valentinbasel/icaro-pcb/svg/pinguicaro-B_Mask.pdf

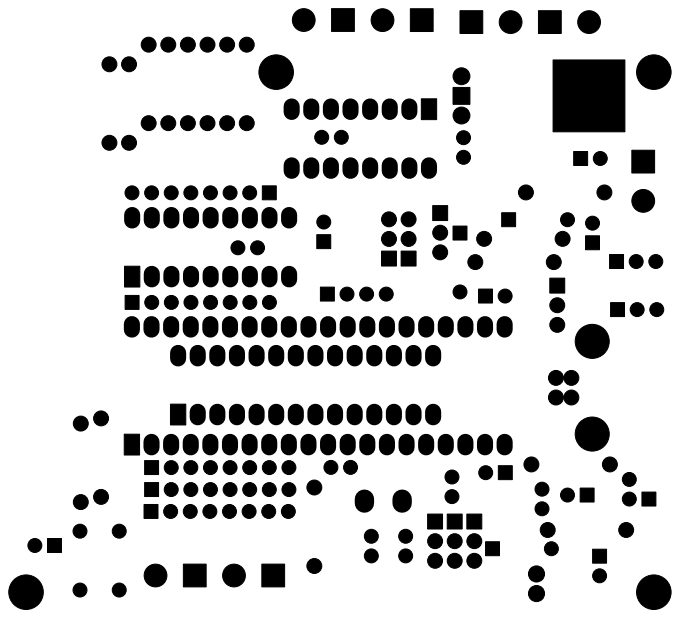
[picture p4: page 1]
