valentinbasel/icaro-pcb/svg/pinguicaro-Back.pdf

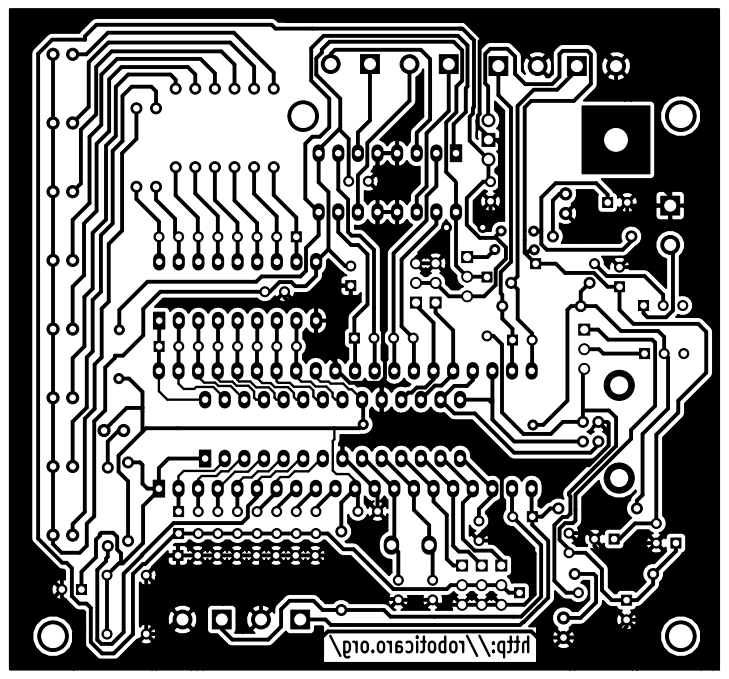
[picture p5: page 1]
