valentinbasel/icaro-pcb/svg/pinguicaro-F_SilkS.pdf

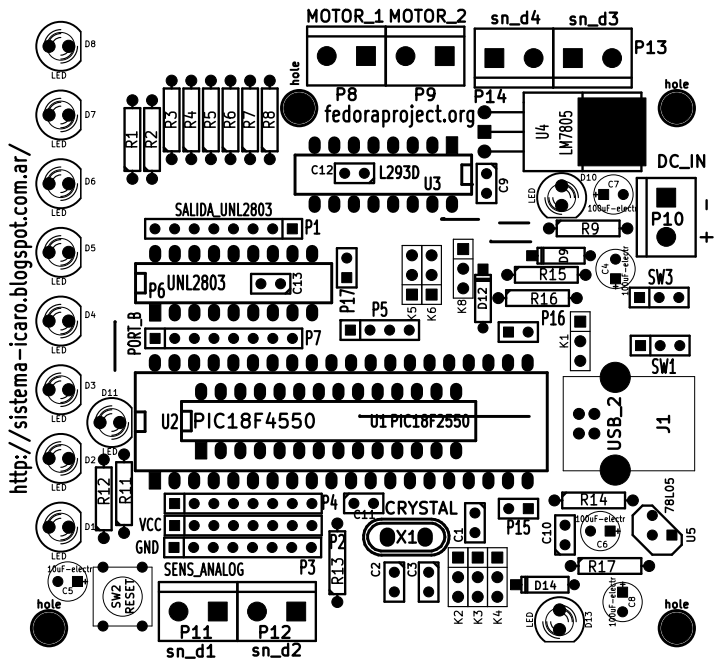
[picture p6: page 1]
