valentinbasel/icaro-pcb/(list of files, drawings)

Other design files:
kicad/pinguicaro.dsn
