valentinbasel/icaro-pcb/(commit log)

2014-09-25 modifique las pattitas de entrada del l293d, para que no quedaran invertidas en el diagrama y fuera mas facil diseñar el pcb sin tantos puentes
    [pinguicaro.kicad_pcb, pinguicaro.sch]
2014-09-25 los leds ya estan montados como corresponde, y hay una sola masa, GND
    [pinguicaro.kicad_pcb]
2014-09-25 reduciendo la cantidad de puentes, ahora hay solo 3
    [pinguicaro.kicad_pcb, pinguicaro.sch]
2014-09-25 reduciendo la cantidad de puentes, ahora hay 2
    [$pinguicaro.sch, pinguicaro.kicad_pcb]
2014-09-25 armado de la fuente, aun falta ver la funete final que se va a usar
    [pinguicaro.kicad_pcb]
2014-09-25 cambios en el esquematico
    [pinguicaro.sch]
2014-09-26 agregue la nueva fuente, lm 78505 y 78l05, reduci a 2 puentes la placa
    [$pinguicaro.sch, pinguicaro.kicad_pcb, pinguicaro.sch]
2014-09-26 zonas y agujeros para montar la placa en superficies
    [pinguicaro.kicad_pcb]
2014-09-29 capacitores de desacople
    [pinguicaro.kicad_pcb, pinguicaro.sch]
2014-09-29 puse la lista de materiales bom
    [pinguicaro.kicad_pcb, pinguicaro.sch]
2014-10-07 version para fabricar
    [pinguicaro-B_Mask.gbs, pinguicaro-B_Paste.gbp, pinguicaro-B_SilkS.gbo, pinguicaro-Back.gbl, pinguicaro-Cmts_User.gbr, pinguicaro-Dwgs_User.gbr, pinguicaro-Eco1_User.gbr, pinguicaro-Eco2_User.gbr]
2014-11-18 arreglado el selector de voltage para l293
    [pinguicaro.kicad_pcb, pinguicaro.sch]
2014-12-10 mejoras menores en el pcb
    [pinguicaro.kicad_pcb, pinguicaro.sch]
2014-12-10 cambios en la serigrafia
    [pinguicaro.kicad_pcb]
2014-12-17 actualziado el .bom y cambios menores en la serigrafia
    [pinguicaro.csv, pinguicaro.kicad_pcb]
2014-12-18 solo dejo el svg, lo demas se puede sacar directamente desde el archivo kicad (gerber,ps, etc). cambios menosres en la serigrafia y en el archivo BOM (cvs). cambios menores en el pcb para alejar un p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
    [$savepcb.brd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]
2015-01-20 cambios menores
    [pinguicaro.kicad_pcb]
2015-01-21 mateo modifico los pines de la bornera de los mototres para mantener compatibilidad con la version np05-np06, modifique los diodos d12 y d14, en ves de esatr conectados a Vcom, van conectados a Vcc (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
    [pinguicaro.kicad_pcb, pinguicaro.sch]
2015-02-03 agregue el jumper p18 para poder puentear el diodo D14, porque si no cuando usamos sensores analogicos , la caida de tension de D14, hace que la fuente VC5 entregue 4,05V en ves de 5V.
    [pinguicaro.csv, pinguicaro.kicad_pcb, pinguicaro.sch]
